zazyzaya/ArduinoWindow/(commit log)

2023-12-03 Basic clock working, but not behaving with button. Maybe hardware issue?
    [synthetic_window.ino]
2024-08-16 Fixed all networking issues
    [synthetic_window.ino, wifi_helpers.h]
2024-08-25 Almost done; need to fast forward to correct cur state and delay ticks:
    [synthetic_window.ino, wifi_helpers.h]
2025-09-24 I think it's finally finished
    [angle_time.csv]
2025-09-29 Adding some restart stuff in loop for RTC failure
    [synthetic_window.ino]
2025-09-30 Light cycle is perfect. I've cracked the code
    [synthetic_window.ino]
2025-09-30 Added clock setting capability. Needs more power to run though
2025-10-02 Switching ints->long to make it work on nano; need to update suntimes for better precision
2025-10-03 Added readme and diagrams
    [angle_time.csv, circuit.xlsx]
2025-10-08 Final code updates and adding docs for how to build
    [circuit.xlsx]
2025-10-13 Fixed midnight rollover error
    [angle_time.csv]
2025-10-14 Added steps for frame to the readme.
2025-10-14 Fixing plot x axis
2025-10-16 Updating LED color selection algo
    [angle_time.csv]
2025-10-27 Adding final painted frame
