zazyzaya/ArduinoWindow/img/inner_frame_schamatic.jpeg

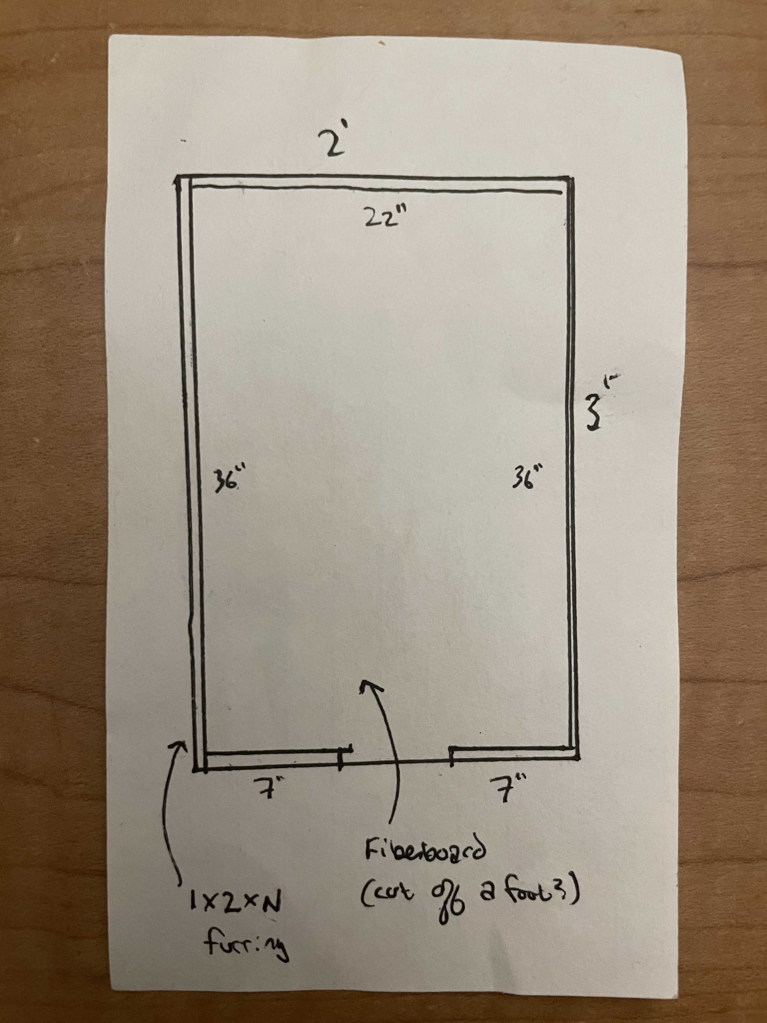
[picture p5: img/inner_frame_schamatic.jpeg]
img/inner_frame_schamatic.jpeg
