zazyzaya/ArduinoWindow/img/inner_frame.jpeg

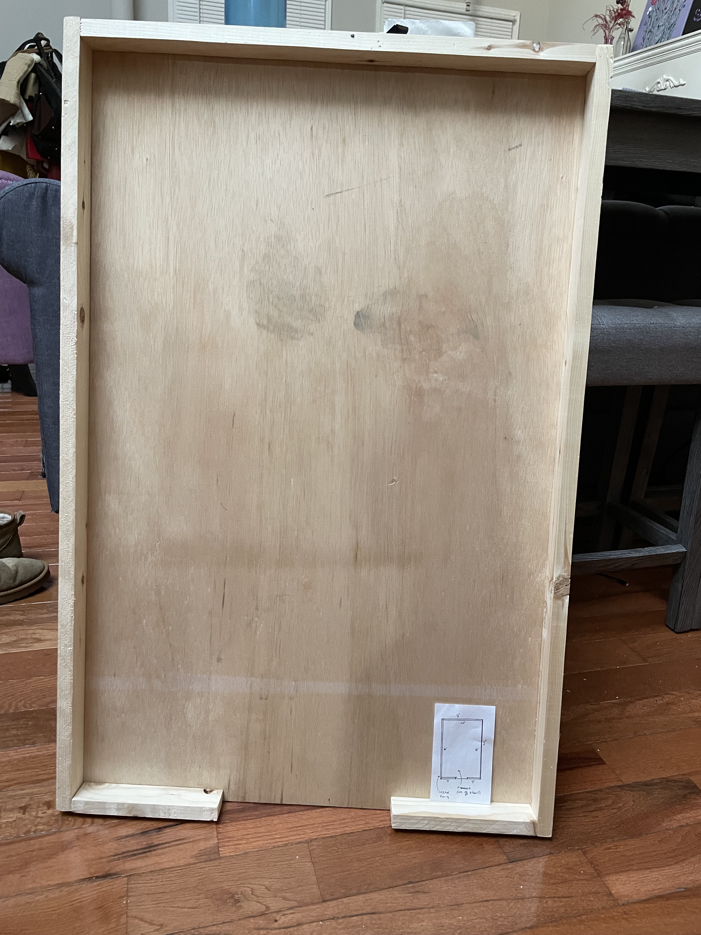
[picture p6: img/inner_frame.jpeg]
img/inner_frame.jpeg
