zazyzaya/ArduinoWindow/img/mounted.jpeg

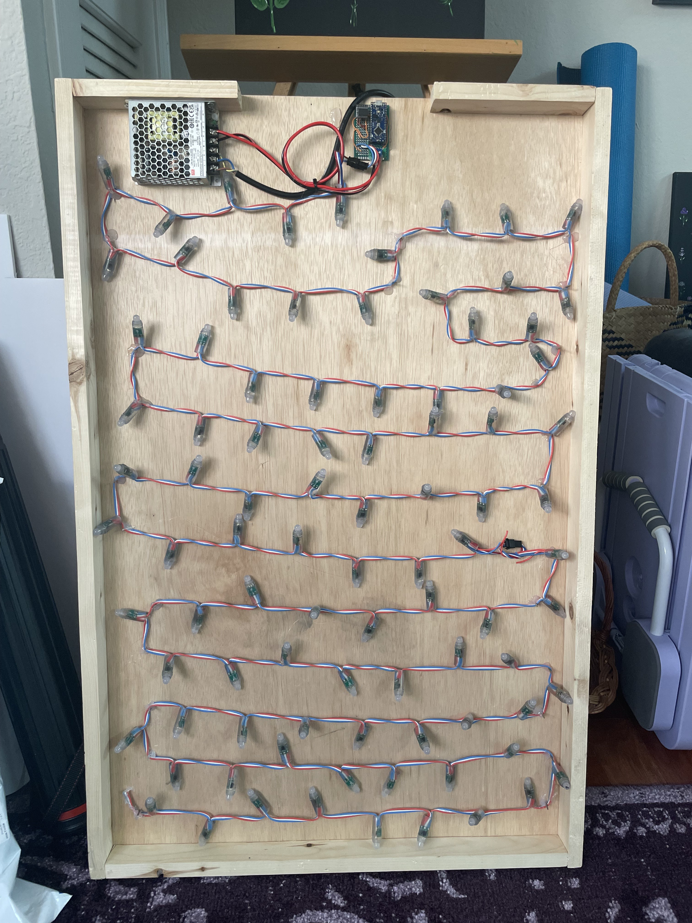
[picture p7: img/mounted.jpeg]
img/mounted.jpeg
