zazyzaya/ArduinoWindow/img/diffuser1.jpeg

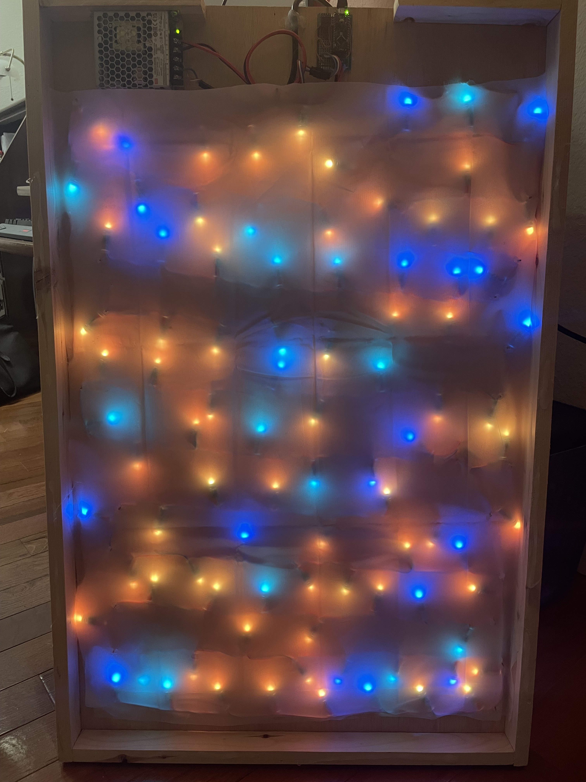
[picture p9: img/diffuser1.jpeg]
img/diffuser1.jpeg
