zazyzaya/ArduinoWindow/img/sheet.jpeg

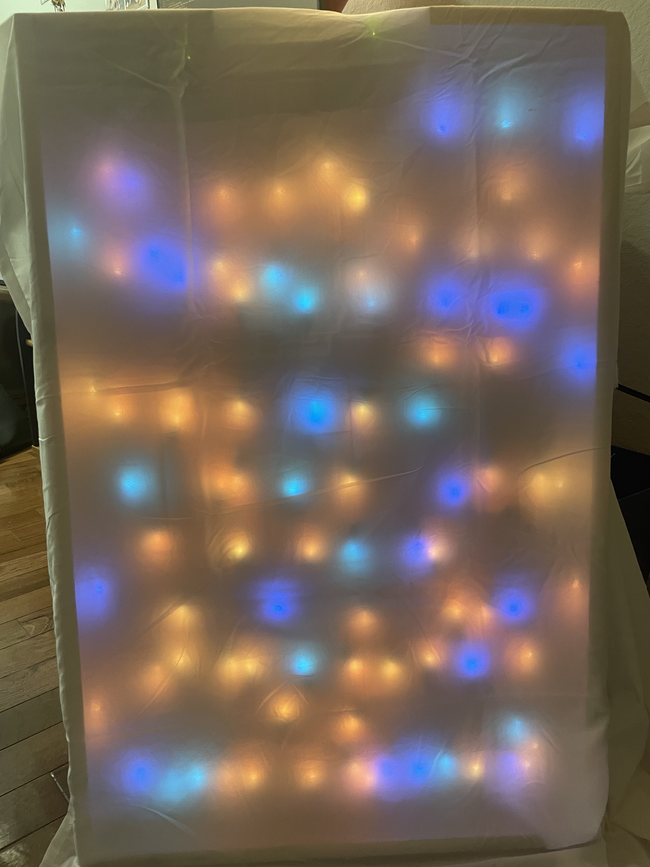
[picture p10: img/sheet.jpeg]
img/sheet.jpeg
