zazyzaya/ArduinoWindow/img/frame_sketch.jpeg

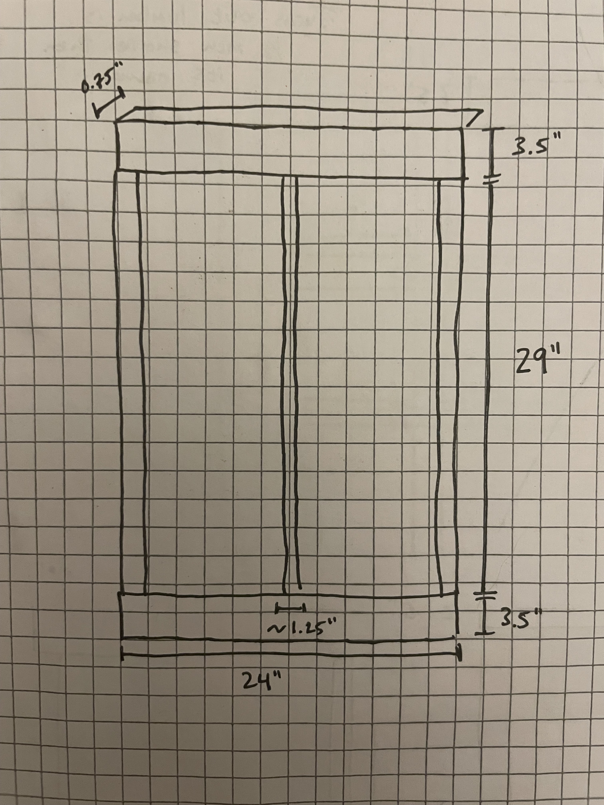
[picture p13: img/frame_sketch.jpeg]
img/frame_sketch.jpeg
