zazyzaya/ArduinoWindow/img/frame_final.jpeg

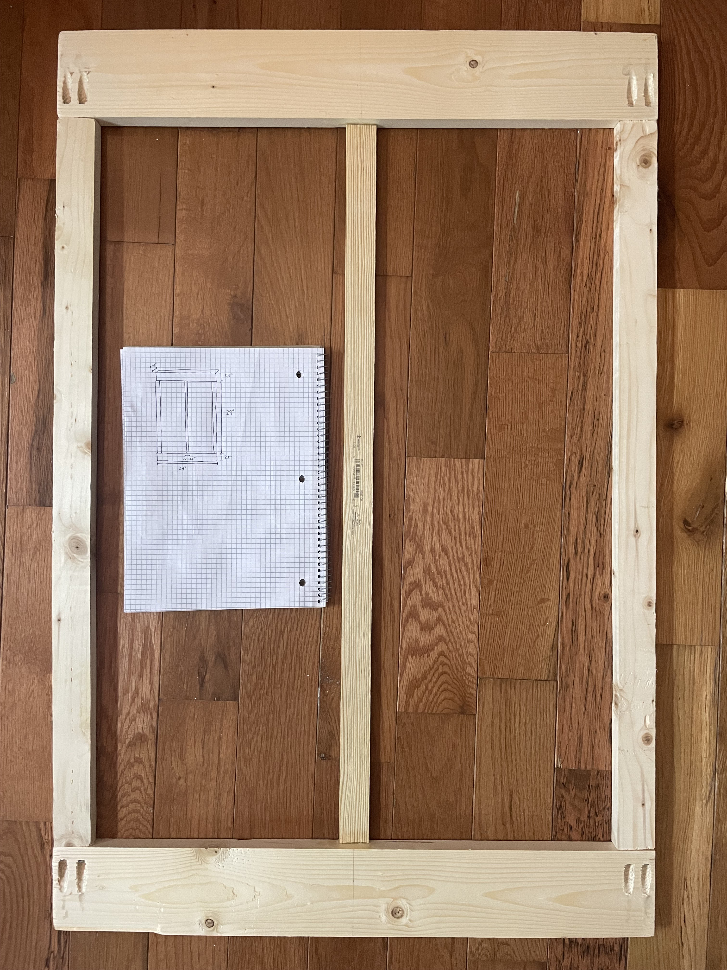
[picture p14: img/frame_final.jpeg]
img/frame_final.jpeg
