zazyzaya/ArduinoWindow/img/frame_final_final.jpeg

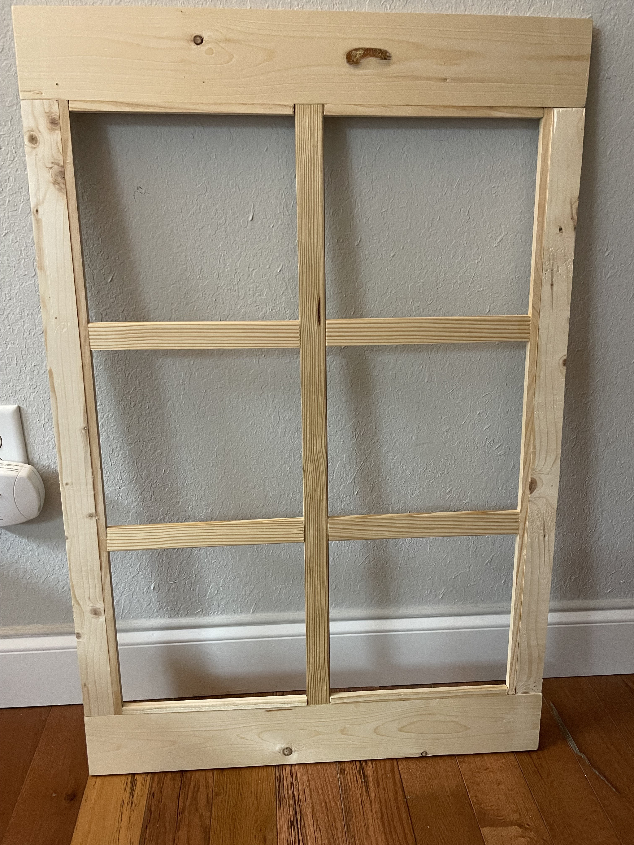
[picture p16: img/frame_final_final.jpeg]
img/frame_final_final.jpeg
